aavdiere/lumos-pcb/bom.xlsx

Comment | Designator | Footprint | JLCPCB Part #
4u7 | C101, C103, C211, C221, C222, C226, C229, C230, C301-C304, C306-C308, C310, C314, C317 | Capacitor_SMD:C_0402_1005Metric
100n | C102, C104, C203, C204, C213-C220, C223-C225, C227, C228, C231, C234, C309, C312, C313, C315, C316 | Capacitor_SMD:C_0402_1005Metric
10u | C202, C311 | Capacitor_SMD:C_0402_1005Metric
1u | C201, C205-C208, C212 | Capacitor_SMD:C_0402_1005Metric
12p | C209, C210, C232, C233 | Capacitor_SMD:C_0402_1005Metric
47u | C305 | Capacitor_SMD:C_0402_1005Metric
20p | C318, C319 | Capacitor_SMD:C_0402_1005Metric
D_Schottky | D101, D201, D202, D301 | Diode_SMD:D_SOD-523
US1D | D102-D104, D302, D305 | Diode_SMD:D_SMA
C138547 | D203 | LED_SMD:LED_0603_1608Metric
C2286 | D204 | LED_SMD:LED_0603_1608Metric
LED | D303, D304 | LED_SMD:LED_0603_1608Metric_Pad1.05x0.95mm_HandSolder
Fuse | F301, F302 | Fuse:Fuseholder_Cylinder-5x20mm_Schurter_0031_8201_Horizontal_Open
1k@100MHz | FB201-FB203 | Inductor_SMD:L_0402_1005Metric
MountingHole | H101-H104 | MountingHole:MountingHole_3.2mm_M3
5V_EXT_INPUT | J101 | Connector_PinHeader_2.54mm:PinHeader_1x02_P2.54mm_Vertical
48V_SCREW_INPUT | J102 | TerminalBlock_Phoenix:TerminalBlock_Phoenix_MKDS-1,5-2-5.08_1x02_P5.08mm_Horizontal
DS18B20 | J103 | Connector_PinHeader_2.54mm:PinHeader_1x03_P2.54mm_Vertical
48V_SCREW_OUTPUT | J104 | TerminalBlock_Phoenix:TerminalBlock_Phoenix_MKDS-1,5-2-5.08_1x02_P5.08mm_Horizontal
STATE_INPUT | J105 | TerminalBlock_Phoenix:TerminalBlock_Phoenix_MKDS-1,5-3-5.08_1x03_P5.08mm_Horizontal
CURRENT_CONTROL | J106 | TerminalBlock_Phoenix:TerminalBlock_Phoenix_MKDS-1,5-2-5.08_1x02_P5.08mm_Horizontal
USB_C_Receptacle_USB2.0 | J201 | Connector_USB:USB_C_Receptacle_HRO_TYPE-C-31-M-12 | C165948
AC_IN | J301 | TerminalBlock_Phoenix:TerminalBlock_Phoenix_MKDS-1,5-2-5.08_1x02_P5.08mm_Horizontal
AC_OUT | J302 | TerminalBlock_Phoenix:TerminalBlock_Phoenix_MKDS-1,5-2-5.08_1x02_P5.08mm_Horizontal
MAINS_INPUT | J303 | TerminalBlock_Phoenix:TerminalBlock_Phoenix_MKDS-1,5-2-5.08_1x02_P5.08mm_Horizontal
MAINS_OUTPUT | J304 | TerminalBlock_Phoenix:TerminalBlock_Phoenix_MKDS-1,5-2-5.08_1x02_P5.08mm_Horizontal
SolderJumper_2_Bridged | JP201 | Jumper:SolderJumper-2_P1.3mm_Bridged2Bar_Pad1.0x1.5mm
FINDER-40.61 | K101, K301, K302 | Relay_THT:Relay_DPDT_Finder_40.52
RK27112MC | POT101 | lumos:RK27112MC
RAC05-05SK/277 | PS301 | lumos:RECOM_RAC05-xxSK-277
BC848 | Q101, Q201, Q202, Q204 | Package_TO_SOT_SMD:SOT-23
2N7002 | Q203, Q205 | Package_TO_SOT_SMD:SOT-23
BC858 | Q301, Q302 | Package_TO_SOT_SMD:SOT-23
470k | R101 | Resistor_SMD:R_0402_1005Metric
0R2 | R103 | Resistor_SMD:R_2512_6332Metric | C309535
0 | R104, R202-R204, R208, R210, R214, R219, R225, R320, R321 | Resistor_SMD:R_0402_1005Metric
220 | R105 | Resistor_SMD:R_0402_1005Metric
10k | R102, R106-R112, R212, R213, R215, R229, R231, R233, R234, R313-R316, R319, R323 | Resistor_SMD:R_0402_1005Metric
10k (NC) | R201 | Resistor_SMD:R_0402_1005Metric
4k7 | R205 | Resistor_SMD:R_0402_1005Metric
5.1k | R206, R207 | Resistor_SMD:R_0402_1005Metric
5M | R209, R322 | Resistor_SMD:R_0402_1005Metric
12k | R216 | Resistor_SMD:R_0402_1005Metric
1k | R218, R221, R230, R301, R302, R306, R307, R310, R312 | Resistor_SMD:R_0402_1005Metric
100k | R217, R220, R222 | Resistor_SMD:R_0402_1005Metric
33k | v R223, R224, R226 | Resistor_SMD:R_0402_1005Metric
2k | R223 | Resistor_SMD:R_0402_1005Metric
0 (NC) | R224 | Resistor_SMD:R_0402_1005Metric
2k2 | R226 | Resistor_SMD:R_0402_1005Metric
0R5 | R227, R228 | Resistor_SMD:R_2512_6332Metric
1M | R232 | Resistor_SMD:R_0805_2012Metric
499k | R235 | Resistor_SMD:R_0805_2012Metric
10k | R303, R304 | Resistor_SMD:R_0805_2012Metric
500 | R305 | Resistor_SMD:R_0402_1005Metric
SMD PUSH BUTTON | R308, R309 | lumos:SW_2-1437565-9
5V | R311 | TestPoint:TestPoint_Pad_D2.0mm
3V3 | R317, R318 | TestPoint:TestPoint_Pad_D2.0mm
1V8 | S201, S202 | TestPoint:TestPoint_Pad_D2.0mm
GND | TP201 | TestPoint:TestPoint_Pad_D2.0mm
AC_5V | TP203 | TestPoint:TestPoint_Pad_D2.0mm
VINTB | TP204 | TestPoint:TestPoint_Pad_D2.0mm
VINTA | TP202, TP205, TP206 | TestPoint:TestPoint_Pad_D2.0mm
ZX | TP301 | TestPoint:TestPoint_Pad_D2.0mm
REVPn | TP302 | TestPoint:TestPoint_Pad_D2.0mm
ZX_I | TP303 | TestPoint:TestPoint_Pad_D2.0mm
1V2 REF | TP304 | TestPoint:TestPoint_Pad_D2.0mm
AC_GND | TP305 | TestPoint:TestPoint_Pad_D2.0mm
INA181 | TP306 | Package_TO_SOT_SMD:SOT-23-6
L293D | TP307 | Package_DIP:DIP-16_W7.62mm
AMS1117-3.3 | TP308 | Package_TO_SOT_SMD:SOT-223-3_TabPin2
USBLC6-2SC6 | U101 | Package_TO_SOT_SMD:SOT-23-6 | C2058784
ESP32-WROOM-E | U102 | lumos:ESP32-WROOM-32E
MCP23S08-xSO | U201 | Package_SO:SOIC-18W_7.5x11.6mm_P1.27mm
FT2232HQ | U202 | lumos:QFN-64-1EP_9x9mm_P0.5mm_EP4.35x4.35mm | C7519
93LC46B | U203 | Package_SO:SOIC-8_3.9x4.9mm_P1.27mm | C701341
ADR280 | U204 | Package_TO_SOT_SMD:SOT-23
ADE7953xCP | U205 | Package_CSP:LFCSP-28-1EP_5x5mm_P0.5mm_EP3.14x3.14mm | C193662
32k768 | U206 | lumos:Crystal_SMD_5032-4Pin_5.0x3.2mm | C16253
12M | U301 | lumos:Crystal_SMD_5032-4Pin_5.0x3.2mm | C2156560
3M58 | U302 | lumos:Crystal_SMD_5032-4Pin_5.0x3.2mm | C515890
 | Y201 |  | C390448
 | Y202 |  | C390438
 | Y301
