aavdiere/lumos-pcb/lumos.kicad_pcb

## KiCad design lumos.kicad_pcb (2023-01-25)

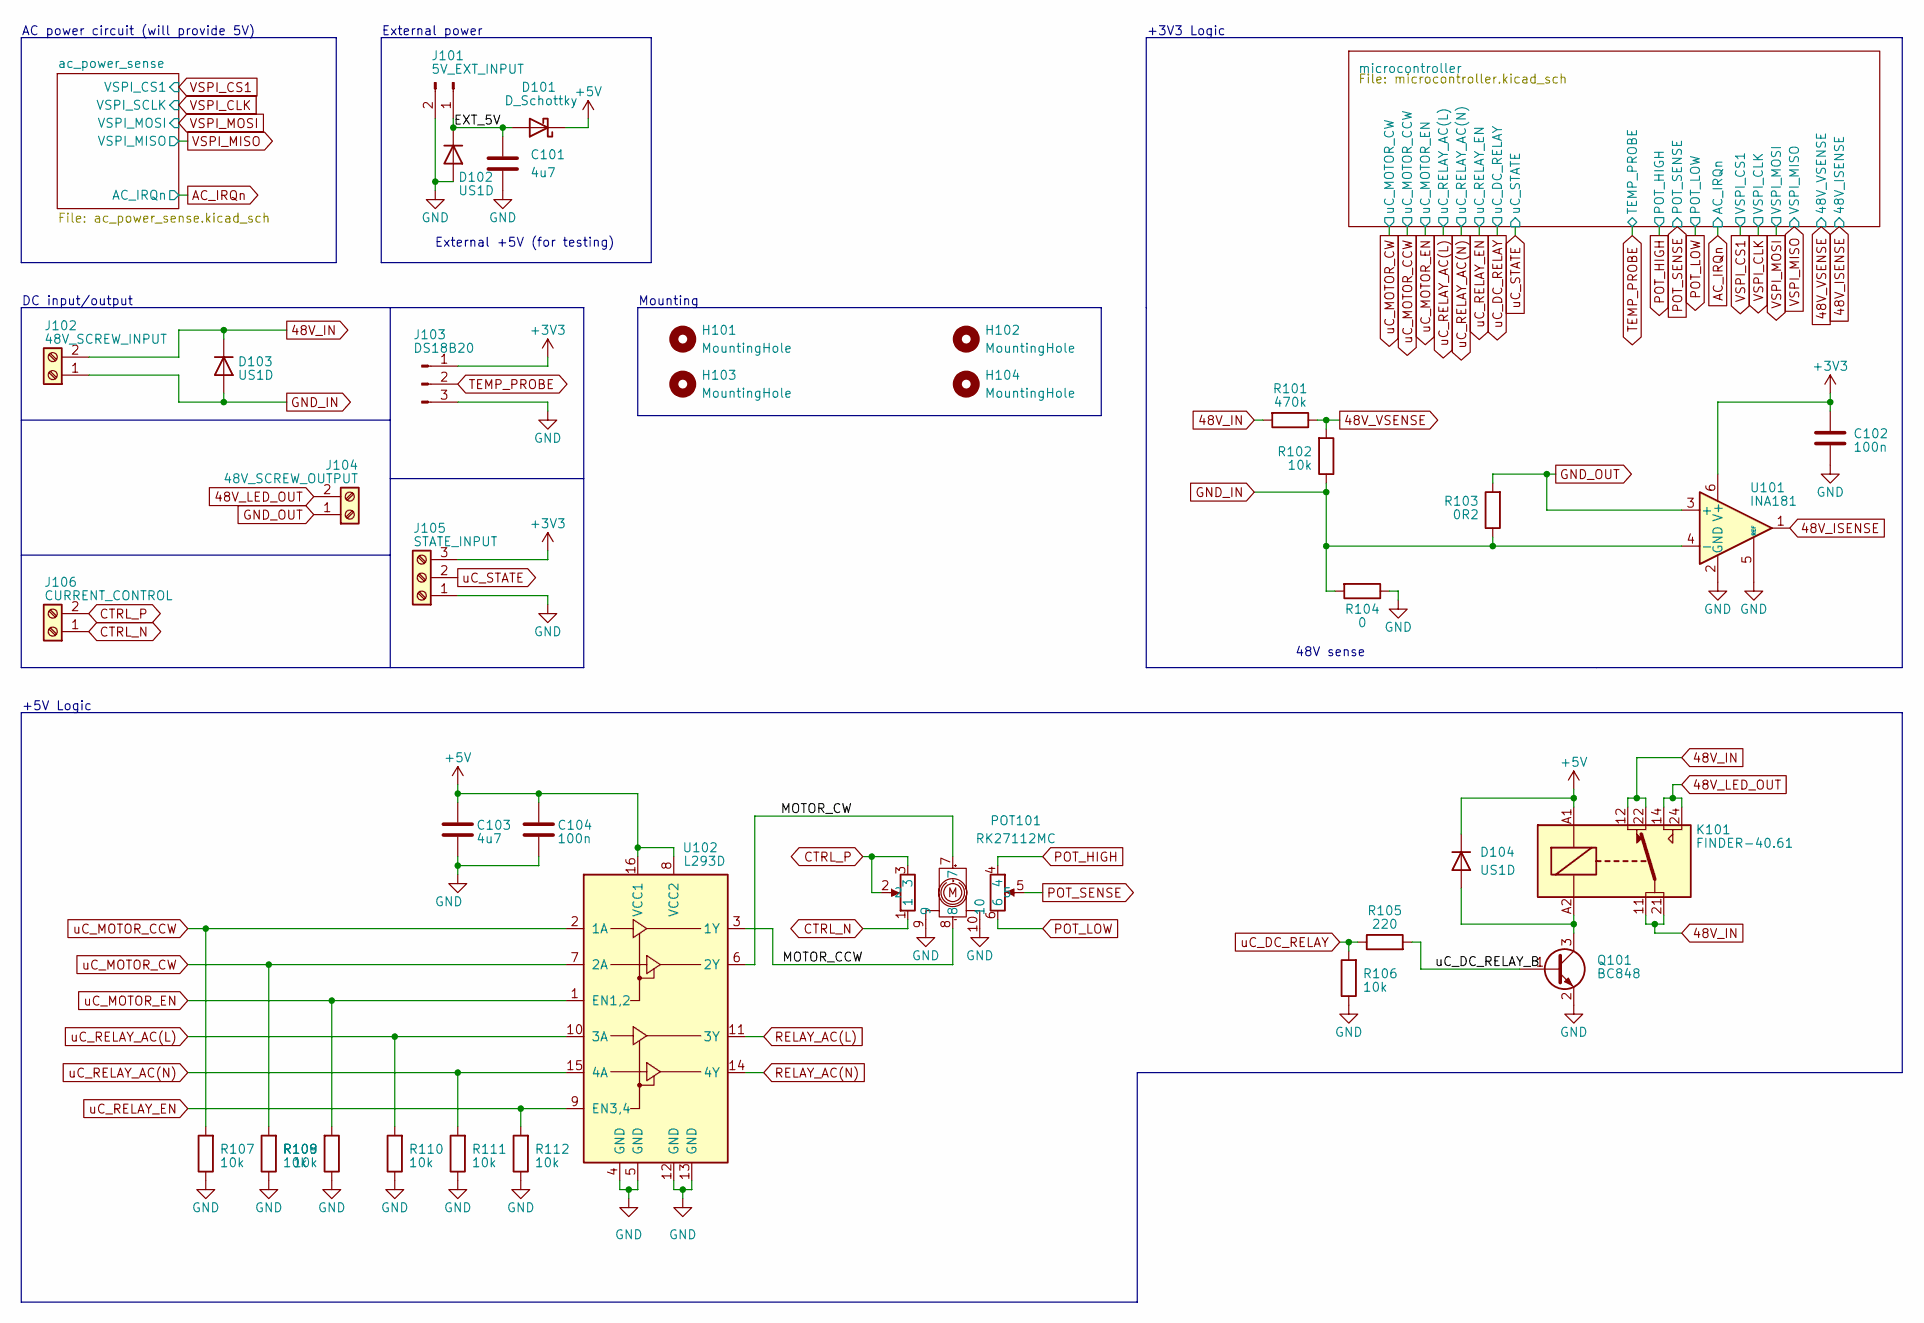
[picture p1: schematic lumos.kicad_sch, Lumos - IoT Grow Light]

Parts:
C101, C103: 4u7; C_0402_1005Metric
C102, C104: 100n; C_0402_1005Metric
D101: D_Schottky; D_SOD-523
D102, D103, D104: US1D; D_SMA
H101, H102, H103, H104: MountingHole; MountingHole_3.2mm_M3
J101: 5V_EXT_INPUT; PinHeader_1x02_P2.54mm_Vertical
J102: 48V_SCREW_INPUT; TerminalBlock_Phoenix_MKDS-1,5-2-5.08_1x02_P5.08mm_Horizont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
J103: DS18B20; PinHeader_1x03_P2.54mm_Vertical
J104: 48V_SCREW_OUTPUT; TerminalBlock_Phoenix_MKDS-1,5-2-5.08_1x02_P5.08mm_Horizont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
J105: STATE_INPUT; TerminalBlock_Phoenix_MKDS-1,5-3-5.08_1x03_P5.08mm_Horizont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
J106: CURRENT_CONTROL; TerminalBlock_Phoenix_MKDS-1,5-2-5.08_1x02_P5.08mm_Horizont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
K101: FINDER-40.61; Relay_DPDT_Finder_40.52
POT101: RK27112MC
Q101: BC848; SOT-23
R101: 470k; R_0402_1005Metric
R102, R106, R107, R108, R109, R110, R111, R112: 10k; R_0402_1005Metric
R103: 0R2; R_2512_6332Metric; JLCPCB Part C309535
R104: 0; R_0402_1005Metric
R105: 220; R_0402_1005Metric
U101: INA181; SOT-23-6; JLCPCB Part C2058784
U102: L293D; DIP-16_W7.62mm

Connections:
48V_IN: D103.1 (K), J102.2, K101.11, K101.12, K101.21, K101.22, R101.2
48V_ISENSE: U101.1; also elsewhere on the board
48V_LED_OUT: J104.2, K101.14, K101.24
48V_VSENSE: R101.1, R102.2; also elsewhere on the board
+3V3: C102.1, J103.1, J105.3, U101.6 (V+); also elsewhere on the board
+5V: C103.1, C104.1, D101.1 (K), D104.1 (K), K101.A1, U102.8 (VCC2), U102.16 (VCC1); also elsewhere on the board
/EXT_5V: C101.1, D101.2 (A), D102.1 (K), J101.1
/MOTOR_CCW: POT101.8, U102.3 (1Y)
/MOTOR_CW: POT101.7, U102.6 (2Y)
/uC_DC_RELAY_B: Q101.1 (B), R105.2
CTRL_N: J106.1, POT101.1
CTRL_P: J106.2, POT101.2, POT101.3
GND: C101.2, C102.2, C103.2, C104.2, D102.2 (A), J101.2, J103.3, J105.1, POT101.9, POT101.10, Q101.2 (E), R104.1, R106.1, R107.1, R108.1, R109.1, R110.1, R111.1, R112.1, U101.2 (GND), U101.5 (REF), U102.4 (GND), U102.5 (GND), U102.12 (GND), U102.13 (GND); also elsewhere on the board
GND_IN: D103.2 (A), J102.1, R102.1, R103.1, R104.2, U101.4 (-)
GND_OUT: J104.1, R103.2, U101.3 (+)
unnamed: D104.2 (A), K101.A2, Q101.3 (C)
POT_HIGH: POT101.4; also elsewhere on the board
POT_LOW: POT101.6; also elsewhere on the board
POT_SENSE: POT101.5; also elsewhere on the board
RELAY_AC(L): U102.11 (3Y); also elsewhere on the board
RELAY_AC(N): U102.14 (4Y); also elsewhere on the board
TEMP_PROBE: J103.2; also elsewhere on the board
uC_DC_RELAY: R105.1, R106.2; also elsewhere on the board
uC_MOTOR_CCW: R107.2, U102.2 (1A); also elsewhere on the board
uC_MOTOR_CW: R108.2, U102.7 (2A); also elsewhere on the board
uC_MOTOR_EN: R109.2, U102.1 (EN1,2); also elsewhere on the board
uC_RELAY_AC(L): R110.2, U102.10 (3A); also elsewhere on the board
uC_RELAY_AC(N): R111.2, U102.15 (4A); also elsewhere on the board
uC_RELAY_EN: R112.2, U102.9 (EN3,4); also elsewhere on the board
uC_STATE: J105.2; also elsewhere on the board

Notes on the sheet:
AC power circuit (will provide 5V)
+5V Logic
External +5V (for testing)
+3V3 Logic
48V sense
DC input/output
Mounting
External power

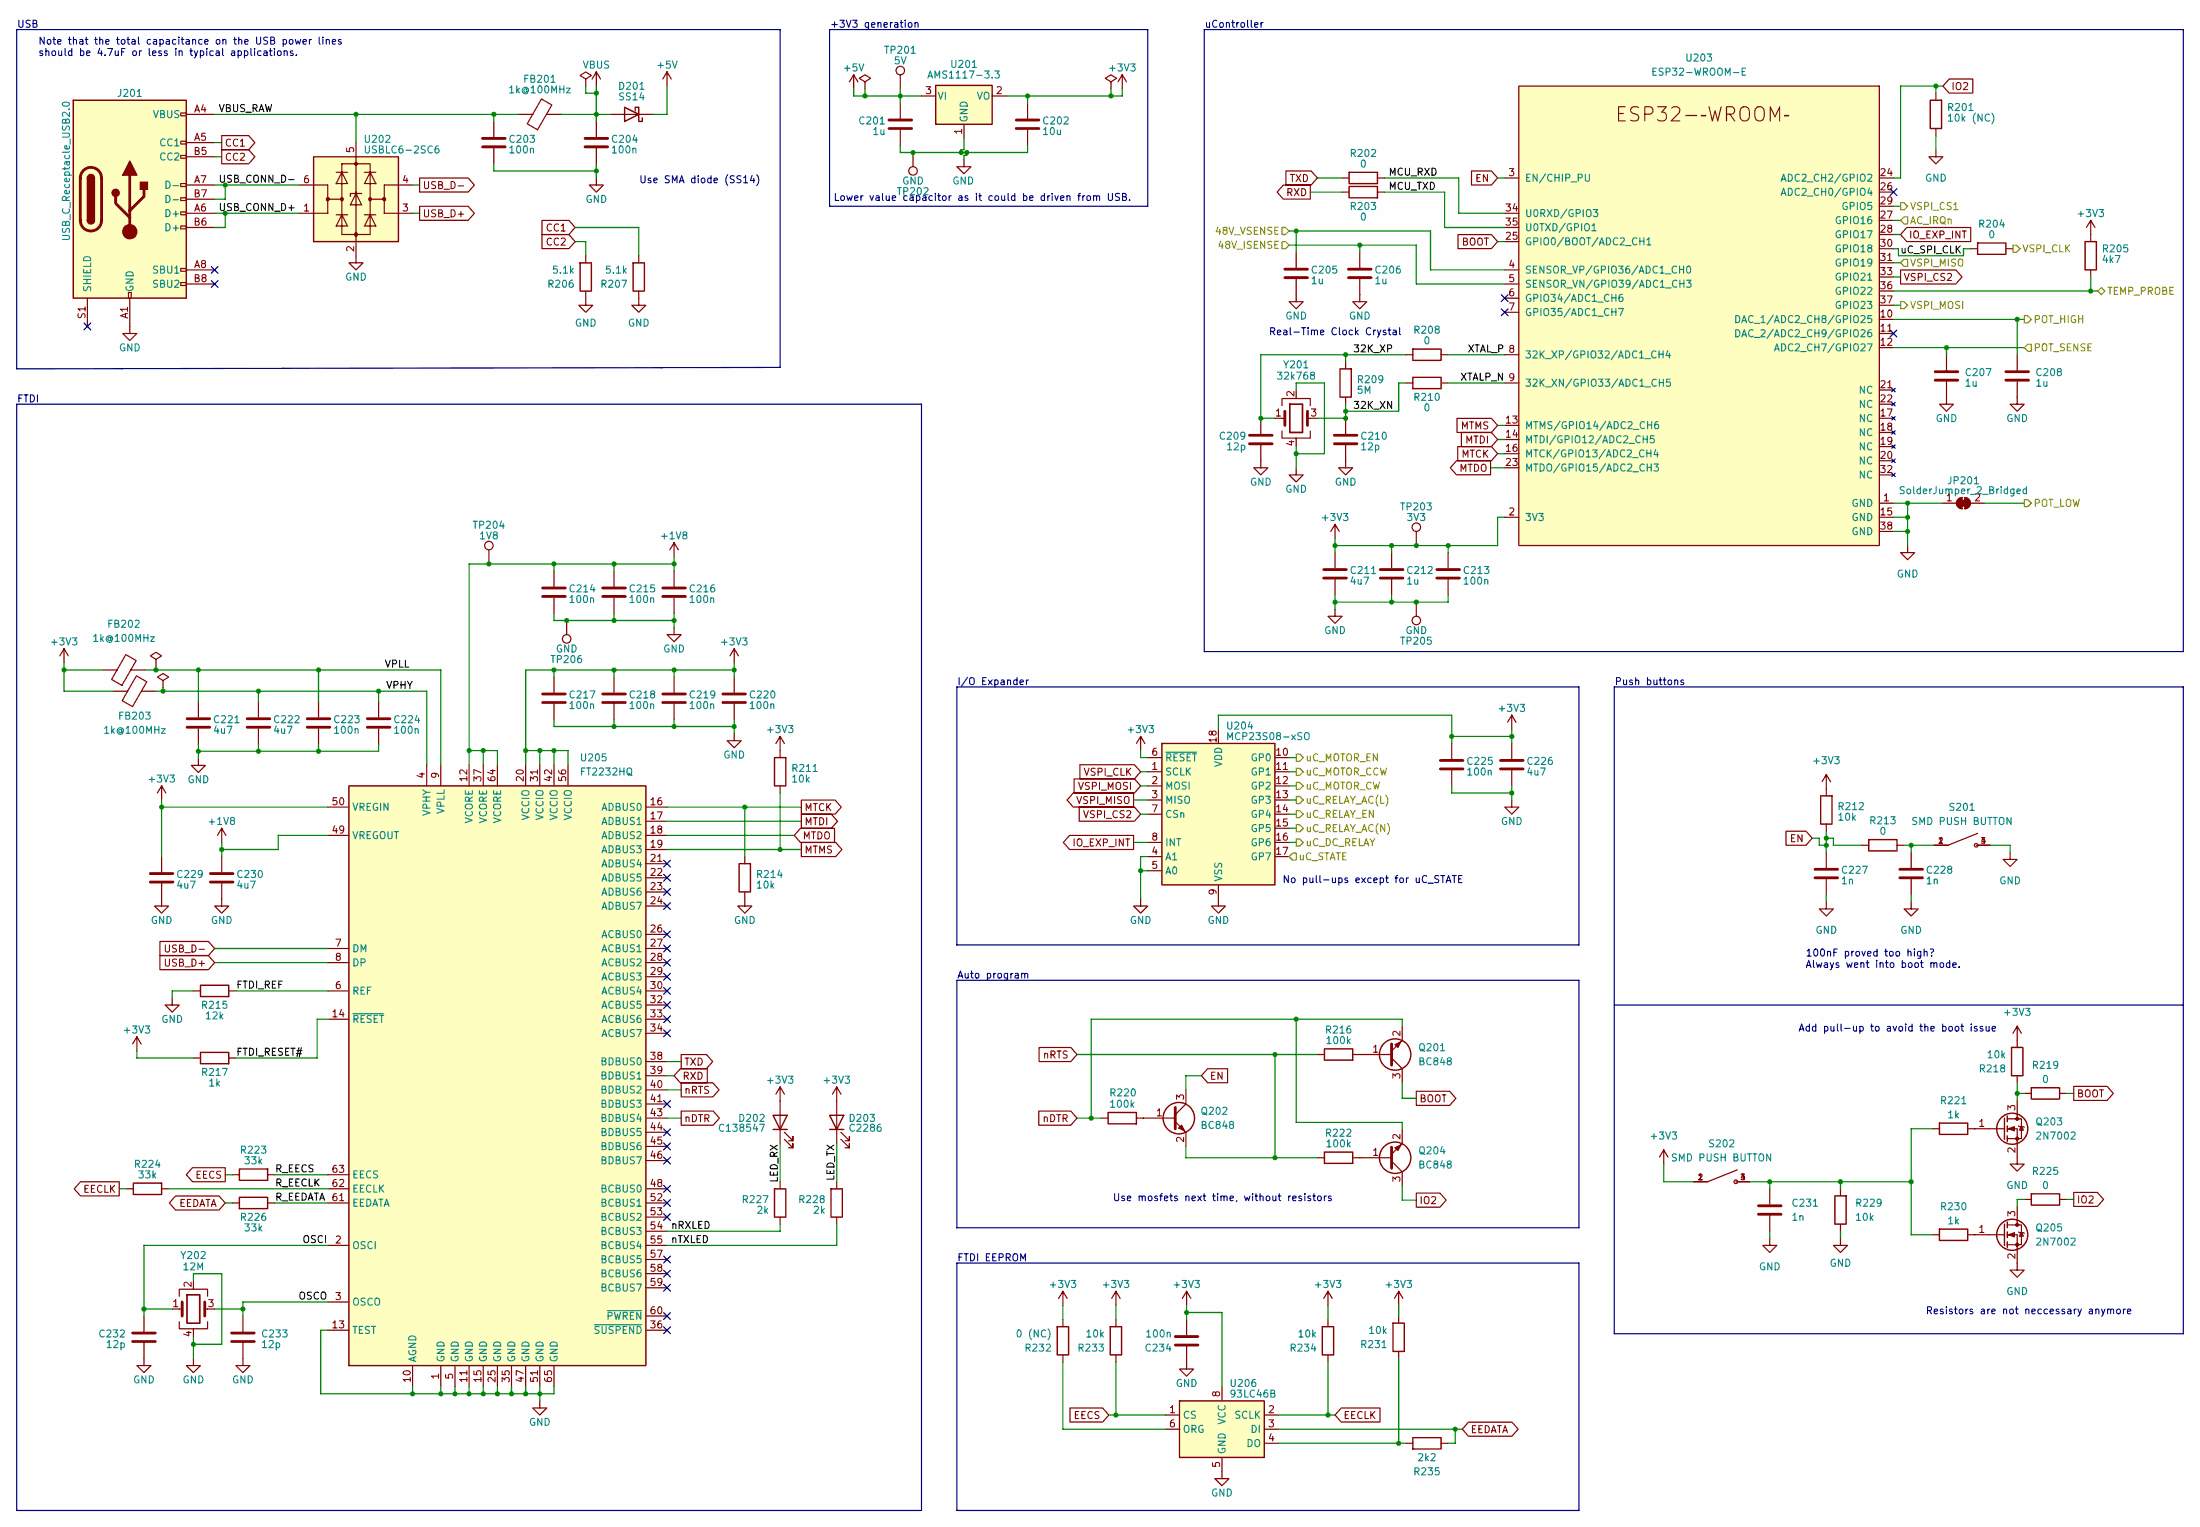
[picture p2: schematic microcontroller.kicad_sch, uController + UART/JTAG over USB]

Parts:
C201, C205, C206, C207, C208, C212: 1u; C_0402_1005Metric
C202: 10u; C_0402_1005Metric
C203, C204, C213, C214, C215, C216, C217, C218, C219, C220, C223, C224, C225, C234: 100n; C_0402_1005Metric
C209, C210, C232, C233: 12p; C_0402_1005Metric
C211, C221, C222, C226, C229, C230: 4u7; C_0402_1005Metric
C227, C228, C231: 1n; C_0402_1005Metric
D201: SS14; D_SOD-523
D202: C138547; LED_0603_1608Metric
D203: C2286; LED_0603_1608Metric
FB201, FB202, FB203: 1k@100MHz; L_0402_1005Metric
J201: USB_C_Receptacle_USB2.0; USB_C_Receptacle_HRO_TYPE-C-31-M-12; JLCPCB Part C165948
JP201: SolderJumper_2_Bridged; SolderJumper-2_P1.3mm_Bridged2Bar_Pad1.0x1.5mm
Q201, Q202, Q204: BC848; SOT-23
Q203, Q205: 2N7002; SOT-23
R201: 10k (NC); R_0402_1005Metric
R202, R203, R204, R208, R210, R213, R219, R225: 0; R_0402_1005Metric
R205: 4k7; R_0402_1005Metric
R206, R207: 5.1k; R_0402_1005Metric
R209: 5M; R_0402_1005Metric
R211, R212, R214, R218, R229, R231, R233, R234: 10k; R_0402_1005Metric
R215: 12k; R_0402_1005Metric
R216, R220, R222: 100k; R_0402_1005Metric
R217, R221, R230: 1k; R_0402_1005Metric
R223, R224, R226: 33k; R_0402_1005Metric
R227, R228: 2k; R_0402_1005Metric
R232: 0 (NC); R_0402_1005Metric
R235: 2k2; R_0402_1005Metric
S201, S202: SMD PUSH BUTTON; SW_2-1437565-9; PARTREV V
TP201: 5V; TestPoint_Pad_D2.0mm
TP202, TP205, TP206: GND; TestPoint_Pad_D2.0mm
TP203: 3V3; TestPoint_Pad_D2.0mm
TP204: 1V8; TestPoint_Pad_D2.0mm
U201: AMS1117-3.3; SOT-223-3_TabPin2
U202: USBLC6-2SC6; SOT-23-6; JLCPCB Part C7519
U203: ESP32-WROOM-E; ESP32-WROOM-32E; JLCPCB Part C701341
U204: MCP23S08-xSO; SOIC-18W_7.5x11.6mm_P1.27mm
U205: FT2232HQ; QFN-64-1EP_9x9mm_P0.5mm_EP4.35x4.35mm; JLCPCB Part C193662
U206: 93LC46B; SOIC-8_3.9x4.9mm_P1.27mm; JLCPCB Part C16253
Y201: 32k768; Crystal_SMD_5032-4Pin_5.0x3.2mm; JLCPCB Part C390448
Y202: 12M; Crystal_SMD_5032-4Pin_5.0x3.2mm; JLCPCB Part C390438

Connections:
48V_ISENSE: C206.1, U203.5 (SENSOR_VN/GPIO39/ADC1_CH3); also elsewhere on the board
48V_VSENSE: C205.1, U203.4 (SENSOR_VP/GPIO36/ADC1_CH0); also elsewhere on the board
+1V8: C214.1, C215.1, C216.1, C230.1, TP204.1, U205.12 (VCORE), U205.37 (VCORE), U205.49 (VREGOUT), U205.64 (VCORE)
+3V3: C202.1, C211.1, C212.1, C213.1, C217.1, C218.1, C219.1, C220.1, C225.1, C226.1, C229.1, C234.2, D202.2 (A), D203.2 (A), FB202.1, FB203.1, R205.2, R211.2, R212.2, R217.1, R218.2, R231.2, R232.2, R233.2, R234.2, S202.1, S202.2, TP203.1, U201.2 (VO), U203.2 (3V3), U204.6 (~RESET), U204.18 (VDD), U205.20 (VCCIO), U205.31 (VCCIO), U205.42 (VCCIO), U205.50 (VREGIN), U205.56 (VCCIO), U206.8 (VCC); also elsewhere on the board
+5V: C201.1, D201.1 (K), TP201.1, U201.3 (VI); also elsewhere on the board
/microcontroller/32K_XN: C210.1, R209.1, R210.2, Y201.3
/microcontroller/32K_XP: C209.2, R208.2, R209.2, Y201.1
/microcontroller/FTDI_REF: R215.2, U205.6 (REF)
/microcontroller/FTDI_RESET#: R217.2, U205.14 (~RESET)
/microcontroller/LED_RX: D202.1 (K), R227.2
/microcontroller/LED_TX: D203.1 (K), R228.2
/microcontroller/MCU_RXD: R202.1, U203.34 (U0RXD/GPIO3)
/microcontroller/MCU_TXD: R203.2, U203.35 (U0TXD/GPIO1)
/microcontroller/OSCI: C232.2, U205.2 (OSCI), Y202.1
/microcontroller/OSCO: C233.1, U205.3 (OSCO), Y202.3
/microcontroller/R_EECLK: R224.2, U205.62 (EECLK)
/microcontroller/R_EECS: R223.2, U205.63 (EECS)
/microcontroller/R_EEDATA: R226.1, U205.61 (EEDATA)
/microcontroller/USB_CONN_D+: J201.A6 (D+), J201.B6 (D+), U202.1 (I/O1)
/microcontroller/USB_CONN_D-: J201.A7 (D-), J201.B7 (D-), U202.6 (I/O1)
/microcontroller/VBUS_RAW: C203.1, FB201.1, J201.A4 (VBUS), J201.A9 (VBUS), J201.B4 (VBUS), J201.B9 (VBUS), U202.5 (VBUS)
/microcontroller/VPHY: C222.1, C224.1, FB203.2, U205.4 (VPHY)
/microcontroller/VPLL: C221.1, C223.1, FB202.2, U205.9 (VPLL)
/microcontroller/XTALP_N: R210.1, U203.9 (32K_XN/GPIO33/ADC1_CH5)
/microcontroller/XTAL_P: R208.1, U203.8 (32K_XP/GPIO32/ADC1_CH4)
/microcontroller/nRXLED: R227.1, U205.54 (BCBUS3)
/microcontroller/nTXLED: R228.1, U205.55 (BCBUS4)
/microcontroller/uC_SPI_CLK: R204.2, U203.30 (GPIO18)
AC_IRQn: U203.27 (GPIO16); also elsewhere on the board
BOOT: Q201.3 (C), R219.1, U203.25 (GPIO0/BOOT/ADC2_CH1)
CC1: J201.A5 (CC1), R207.2
CC2: J201.B5 (CC2), R206.2
EECLK: R224.1, R234.1, U206.2 (SCLK)
EECS: R223.1, R233.1, U206.1 (CS)
EEDATA: R226.2, R235.1, U206.3 (DI)
EN: C227.1, Q202.3 (C), R212.1, R213.2, U203.3 (EN/CHIP_PU)
GND: C201.2, C202.2, C203.2, C204.2, C205.2, C206.2, C207.2, C208.2, C209.1, C210.2, C211.2, C212.2, C213.2, C214.2, C215.2, C216.2, C217.2, C218.2, C219.2, C220.2, C221.2, C222.2, C223.2, C224.2, C225.2, C226.2, C227.2, C228.2, C229.2, C230.2, C231.2, C232.1, C233.2, C234.1, J201.A1 (GND), J201.A12 (GND), J201.B1 (GND), J201.B12 (GND), JP201.1 (A), Q203.2 (S), Q205.2 (S), R201.1, R206.1, R207.1, R214.1, R215.1, R229.1, S201.3, S201.4, TP202.1, TP205.1, TP206.1, U201.1 (GND), U202.2 (GND), U203.1 (GND), U203.15 (GND), U203.38 (GND), U204.4 (A1), U204.5 (A0), U204.9 (VSS), U205.1 (GND), U205.5 (GND), U205.10 (AGND), U205.11 (GND), U205.13 (TEST), U205.15 (GND), U205.25 (GND), U205.35 (GND), U205.47 (GND), U205.51 (GND), U205.65 (GND), U206.5 (GND), Y201.2, Y201.4, Y202.2, Y202.4; also elsewhere on the board
IO2: Q204.3 (C), R201.2, R225.1, U203.24 (ADC2_CH2/GPIO2)
IO_EXP_INT: U203.28 (GPIO17), U204.8 (INT)
MTCK: R214.2, U203.16 (MTCK/GPIO13/ADC2_CH4), U205.16 (ADBUS0)
MTDI: U203.14 (MTDI/GPIO12/ADC2_CH5), U205.17 (ADBUS1)
MTDO: U203.23 (MTDO/GPIO15/ADC2_CH3), U205.18 (ADBUS2)
MTMS: R211.1, U203.13 (MTMS/GPIO14/ADC2_CH6), U205.19 (ADBUS3)
unnamed: C228.1, R213.1, S201.1, S201.2
unnamed: C231.1, R221.2, R229.2, R230.2, S202.3, S202.4
unnamed: Q201.1 (B), R216.2
unnamed: Q202.1 (B), R220.2
unnamed: Q203.1 (G), R221.1
unnamed: Q203.3 (D), R218.1, R219.2
unnamed: Q204.1 (B), R222.2
unnamed: Q205.1 (G), R230.1
unnamed: Q205.3 (D), R225.2
unnamed: R231.1, R235.2, U206.4 (DO)
unnamed: R232.1, U206.6 (ORG)
POT_HIGH: C208.1, U203.10 (DAC_1/ADC2_CH8/GPIO25); also elsewhere on the board
POT_LOW: JP201.2 (B); also elsewhere on the board
POT_SENSE: C207.1, U203.12 (ADC2_CH7/GPIO27); also elsewhere on the board
RXD: R203.1, U205.39 (BDBUS1)
TEMP_PROBE: R205.1, U203.36 (GPIO22); also elsewhere on the board
TXD: R202.2, U205.38 (BDBUS0)
USB_D+: U202.3 (I/O2), U205.8 (DP)
USB_D-: U202.4 (I/O2), U205.7 (DM)
VBUS: C204.1, D201.2 (A), FB201.2
VSPI_CLK: R204.1, U204.1 (SCLK); also elsewhere on the board
VSPI_CS1: U203.29 (GPIO5); also elsewhere on the board
VSPI_CS2: U203.33 (GPIO21), U204.7 (CSn)
VSPI_MISO: U203.31 (GPIO19), U204.3 (MISO); also elsewhere on the board
VSPI_MOSI: U203.37 (GPIO23), U204.2 (MOSI); also elsewhere on the board
nDTR: Q201.2 (E), Q204.2 (E), R220.1, U205.43 (BDBUS4)
nRTS: Q202.2 (E), R216.1, R222.1, U205.40 (BDBUS2)
uC_DC_RELAY: U204.16 (GP6); also elsewhere on the board
uC_MOTOR_CCW: U204.11 (GP1); also elsewhere on the board
uC_MOTOR_CW: U204.12 (GP2); also elsewhere on the board
uC_MOTOR_EN: U204.10 (GP0); also elsewhere on the board
uC_RELAY_AC(L): U204.13 (GP3); also elsewhere on the board
uC_RELAY_AC(N): U204.15 (GP5); also elsewhere on the board
uC_RELAY_EN: U204.14 (GP4); also elsewhere on the board
uC_STATE: U204.17 (GP7); also elsewhere on the board

Notes on the sheet:
I/O Expander
Push buttons
FTDI
Note that the total capacitance on the USB power lines should be 4.7uF or less in typical applications.
No pull-ups except for uC_STATE
uController
Real-Time Clock Crystal
Add pull-up to avoid the boot issue
Auto program
Use SMA diode (SS14)
Resistors are not neccessary anymore
Use mosfets next time, without resistors
FTDI EEPROM
Lower value capacitor as it could be driven from USB.
100nF proved too high? Always went into boot mode.
USB
+3V3 generation

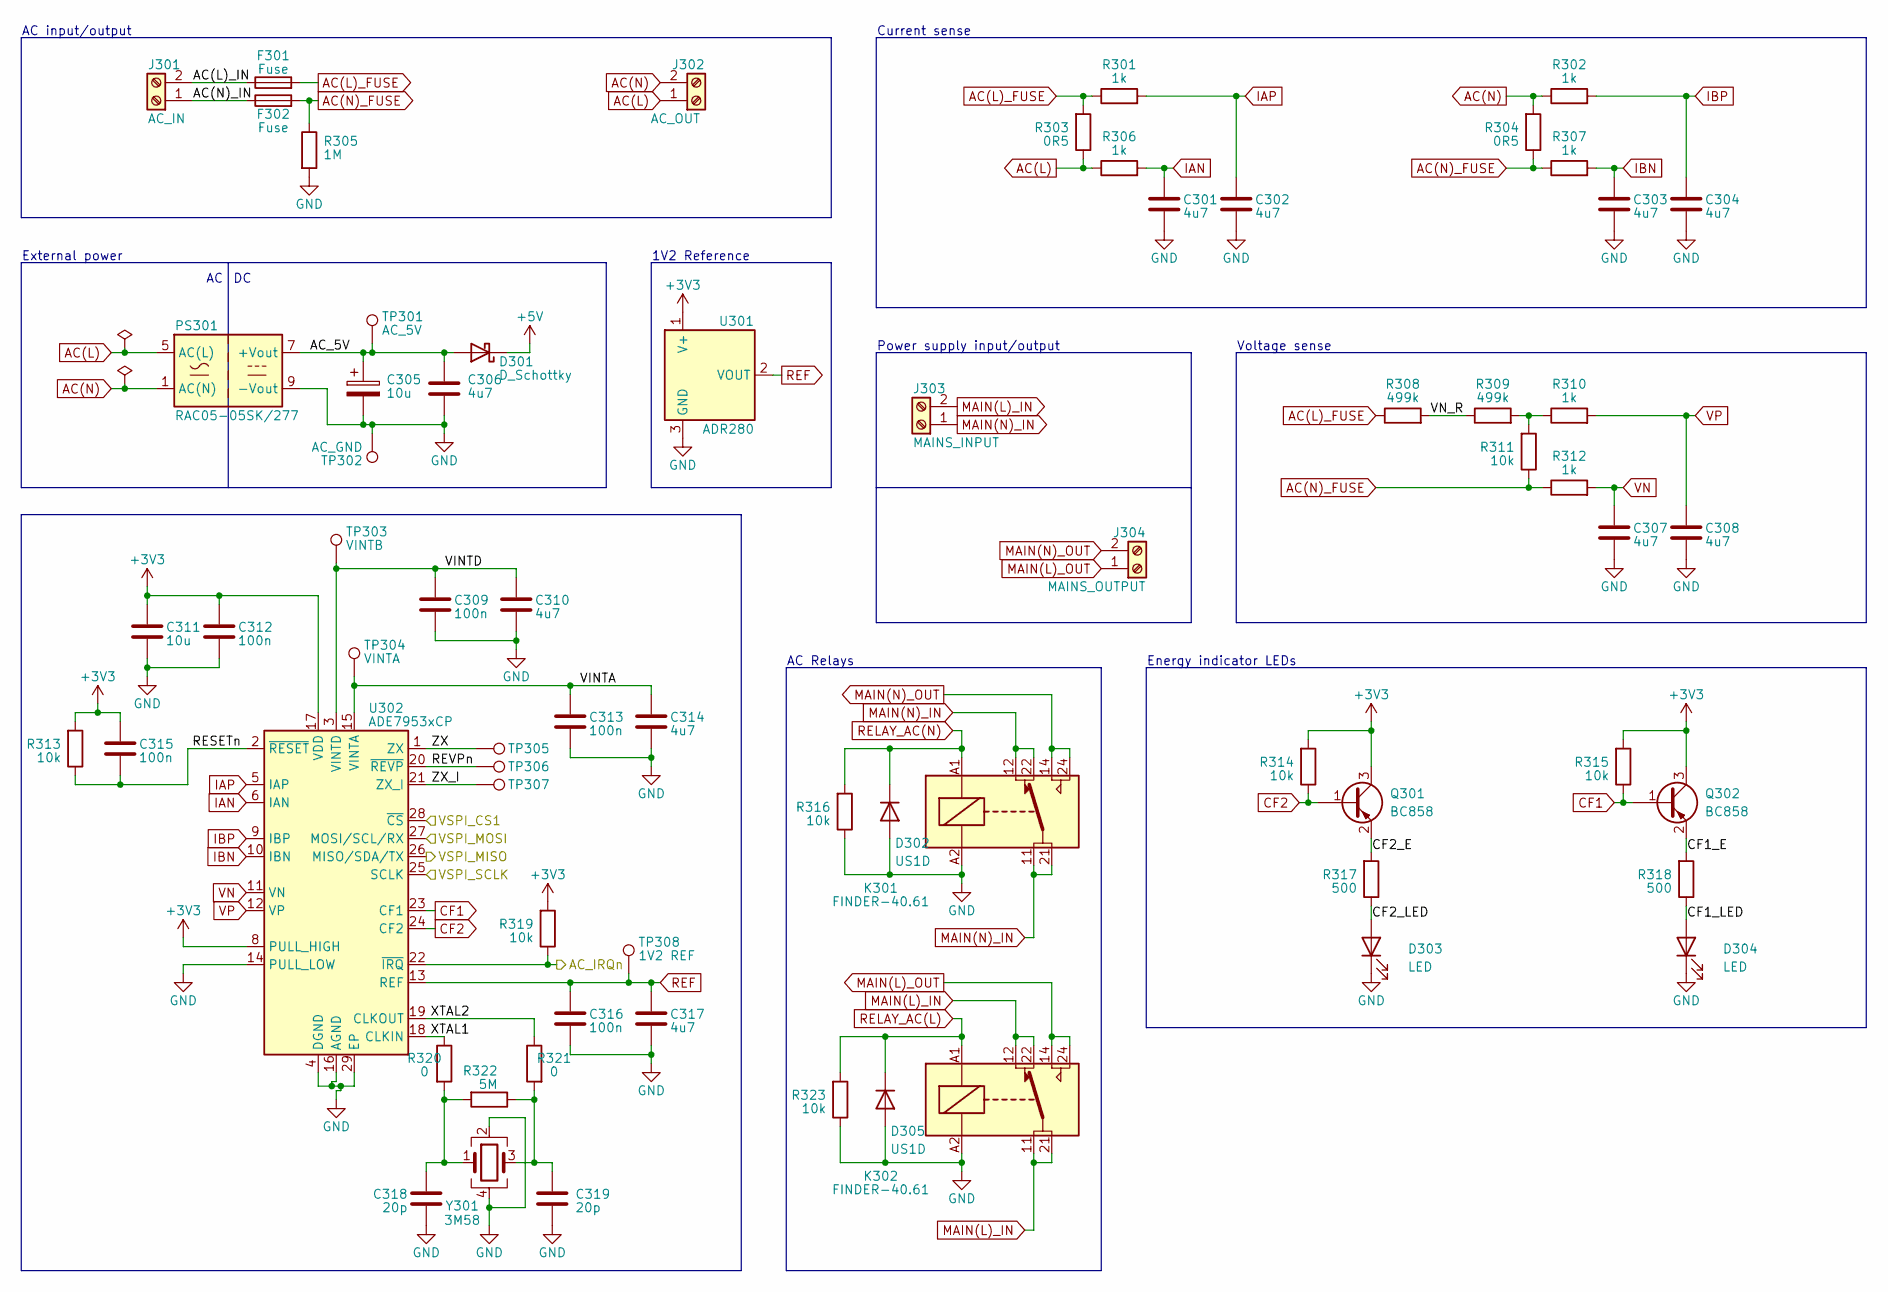
[picture p3: schematic ac_power_sense.kicad_sch, AC Input / Power Sense]

Parts:
C301, C302, C303, C304, C306, C307, C308, C310, C314, C317: 4u7; C_0402_1005Metric
C305, C311: 10u; C_0402_1005Metric
C309, C312, C313, C315, C316: 100n; C_0402_1005Metric
C318, C319: 20p; C_0402_1005Metric
D301: D_Schottky; D_SOD-523
D302, D305: US1D; D_SMA
D303, D304: LED; LED_0603_1608Metric_Pad1.05x0.95mm_HandSolder
F301, F302: Fuse; Fuseholder_Cylinder-5x20mm_Schurter_0031_8201_Horizontal_Op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
J301: AC_IN; TerminalBlock_Phoenix_MKDS-1,5-2-5.08_1x02_P5.08mm_Horizont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
J302: AC_OUT; TerminalBlock_Phoenix_MKDS-1,5-2-5.08_1x02_P5.08mm_Horizont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
J303: MAINS_INPUT; TerminalBlock_Phoenix_MKDS-1,5-2-5.08_1x02_P5.08mm_Horizont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
J304: MAINS_OUTPUT; TerminalBlock_Phoenix_MKDS-1,5-2-5.08_1x02_P5.08mm_Horizont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
K301, K302: FINDER-40.61; Relay_DPDT_Finder_40.52
PS301: RAC05-05SK/277; RECOM_RAC05-xxSK-277
Q301, Q302: BC858; SOT-23
R301, R302, R306, R307, R310, R312: 1k; R_0402_1005Metric
R303, R304: 0R5; R_2512_6332Metric
R305: 1M; R_0805_2012Metric
R308, R309: 499k; R_0805_2012Metric
R311: 10k; R_0805_2012Metric
R313, R314, R315, R316, R319, R323: 10k; R_0402_1005Metric
R317, R318: 500; R_0402_1005Metric
R320, R321: 0; R_0402_1005Metric
R322: 5M; R_0402_1005Metric
TP301: AC_5V; TestPoint_Pad_D2.0mm
TP302: AC_GND; TestPoint_Pad_D2.0mm
TP303: VINTB; TestPoint_Pad_D2.0mm
TP304: VINTA; TestPoint_Pad_D2.0mm
TP305: ZX; TestPoint_Pad_D2.0mm
TP306: REVPn; TestPoint_Pad_D2.0mm
TP307: ZX_I; TestPoint_Pad_D2.0mm
TP308: 1V2 REF; TestPoint_Pad_D2.0mm
U301: ADR280; SOT-23; JLCPCB Part C2156560
U302: ADE7953xCP; LFCSP-28-1EP_5x5mm_P0.5mm_EP3.14x3.14mm; JLCPCB Part C515890
Y301: 3M58; Crystal_SMD_5032-4Pin_5.0x3.2mm

Connections:
+3V3: C311.1, C312.1, C315.1, Q301.3 (C), Q302.3 (C), R313.2, R314.2, R315.2, R319.2, U301.1 (V+), U302.7 (PULL_HIGH), U302.8 (PULL_HIGH), U302.17 (VDD); also elsewhere on the board
+5V: D301.1 (K); also elsewhere on the board
/ac_power_sense/AC(L)_IN: F301.1, J301.2
/ac_power_sense/AC(N)_IN: F302.1, J301.1
/ac_power_sense/AC_5V: C305.1, C306.1, D301.2 (A), PS301.7 (+Vout), TP301.1
/ac_power_sense/CF1_E: Q302.2 (E), R318.2
/ac_power_sense/CF1_LED: D304.2 (A), R318.1
/ac_power_sense/CF2_E: Q301.2 (E), R317.2
/ac_power_sense/CF2_LED: D303.2 (A), R317.1
/ac_power_sense/RESETn: C315.2, R313.1, U302.2 (~RESET)
/ac_power_sense/REVPn: TP306.1, U302.20 (~REVP)
/ac_power_sense/VINTA: C313.1, C314.1, TP304.1, U302.15 (VINTA)
/ac_power_sense/VINTD: C309.1, C310.1, TP303.1, U302.3 (VINTD)
/ac_power_sense/VN_R: R308.2, R309.1
/ac_power_sense/XTAL1: R320.1, U302.18 (CLKIN)
/ac_power_sense/XTAL2: R321.1, U302.19 (CLKOUT)
/ac_power_sense/ZX: TP305.1, U302.1 (ZX)
/ac_power_sense/ZX_I: TP307.1, U302.21 (ZX_I)
AC(L): J302.1, PS301.5 (AC(L)), R303.1, R306.1
AC(L)_FUSE: F301.2, R301.1, R303.2, R308.1
AC(N): J302.2, PS301.1 (AC(N)), R302.1, R304.2
AC(N)_FUSE: F302.2, R304.1, R305.1, R307.1, R311.1, R312.1
AC_IRQn: R319.1, U302.22 (~IRQ); also elsewhere on the board
CF1: Q302.1 (B), R315.1, U302.23 (CF1)
CF2: Q301.1 (B), R314.1, U302.24 (CF2)
GND: C301.2, C302.2, C303.2, C304.2, C305.2, C306.2, C307.2, C308.2, C309.2, C310.2, C311.2, C312.2, C313.2, C314.2, C316.2, C317.2, C318.1, C319.2, D302.2 (A), D303.1 (K), D304.1 (K), D305.2 (A), K301.A2, K302.A2, PS301.9 (-Vout), R305.2, R316.1, R323.1, TP302.1, U301.3 (GND), U302.4 (DGND), U302.14 (PULL_LOW), U302.16 (AGND), U302.29 (EP), Y301.2, Y301.4; also elsewhere on the board
IAN: C301.1, R306.2, U302.6 (IAN)
IAP: C302.1, R301.2, U302.5 (IAP)
IBN: C303.1, R307.2, U302.10 (IBN)
IBP: C304.1, R302.2, U302.9 (IBP)
MAIN(L)_IN: J303.2, K302.11, K302.12, K302.21, K302.22
MAIN(L)_OUT: J304.1, K302.14, K302.24
MAIN(N)_IN: J303.1, K301.11, K301.12, K301.21, K301.22
MAIN(N)_OUT: J304.2, K301.14, K301.24
unnamed: C318.2, R320.2, R322.2, Y301.1
unnamed: C319.1, R321.2, R322.1, Y301.3
unnamed: R309.2, R310.1, R311.2
REF: C316.1, C317.1, TP308.1, U301.2 (VOUT), U302.13 (REF)
RELAY_AC(L): D305.1 (K), K302.A1, R323.2; also elsewhere on the board
RELAY_AC(N): D302.1 (K), K301.A1, R316.2; also elsewhere on the board
VN: C307.1, R312.2, U302.11 (VN)
VP: C308.1, R310.2, U302.12 (VP)
VSPI_CLK: U302.25 (SCLK); also elsewhere on the board
VSPI_CS1: U302.28 (~CS); also elsewhere on the board
VSPI_MISO: U302.26 (MISO/SDA/TX); also elsewhere on the board
VSPI_MOSI: U302.27 (MOSI/SCL/RX); also elsewhere on the board

Notes on the sheet:
AC Relays
Energy indicator LEDs
Power supply input/output
Voltage sense
Current sense
1V2 Reference
External power
AC input/output

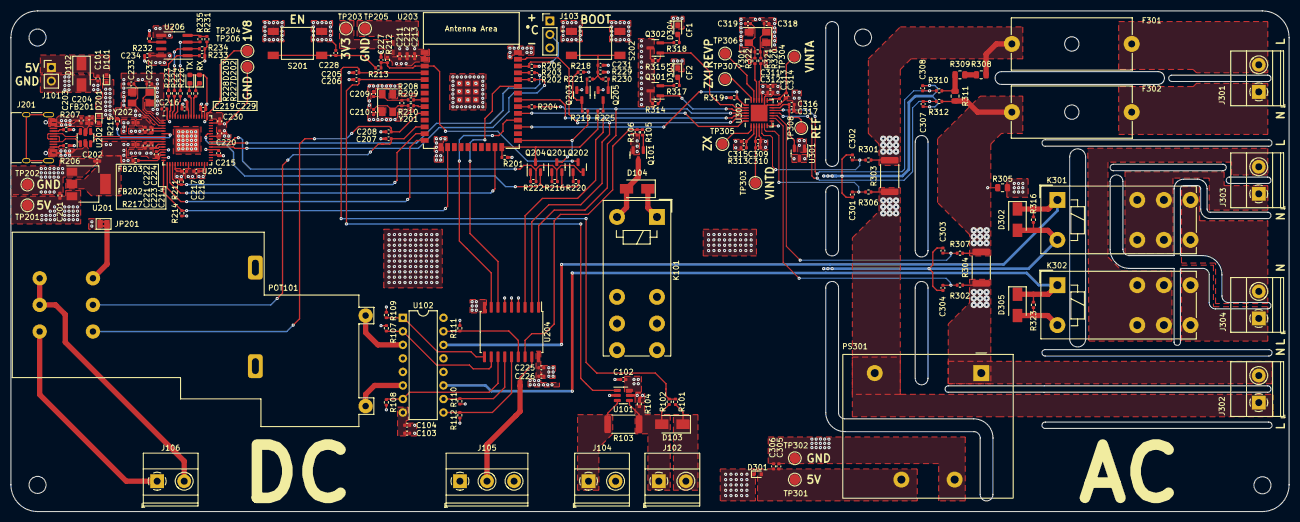
[picture p4: board lumos.kicad_pcb from above]

Board: 4 copper layers, 240.0 x 94.0 mm, 202 parts (0 on the bottom side), 127 nets.
